JavierIH/beerbot/README.md

# beerbot
BeerBOT: beer extraction experimental research robot
