JavierIH/beerbot/doc/frontpage.tex

\newcommand{\frontpage}[4]
{
\begin{center}
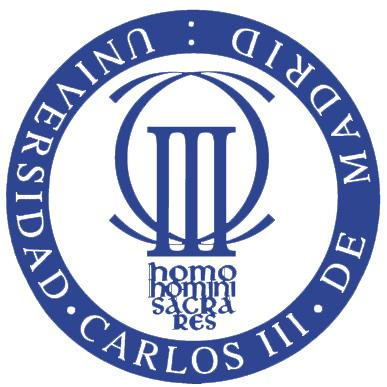
[picture p13: doc/images/uc3m.jpg]
\\[2cm]
\textsc{\LARGE Universidad Carlos III de Madrid}\\[0.5cm]
\textsc{\Large #1}\\[3cm]

% Title
{\huge \bfseries{#2}\\[7cm]}

% Author and supervisor
\begin{minipage}{0.35\textwidth}
\begin{flushleft} \large
\emph{Autores:}\\
#3\\
\end{flushleft}
\end{minipage}
\begin{minipage}{0.4\textwidth}
\begin{flushright} \large
\emph{Profesores:}\\
#4
\end{flushright}\end{minipage}\vfill

% Bottom of the page
{\large \today}

\end{center}
%
\newpage
%
}
