JavierIH/beerbot/doc/estado_del_arte.tex

\chapter{Estado del arte}
\label{estado del arte}

En esta sección se realizara un breve estudio acerca de los dos conceptos principales que conforman este trabajo. Se comenzará hablando sobre la navegación autónoma en el campo de la robótica, mostrando las diferentes partes que la conforman para a continuación entrar en el campo de la impresión 3D, centrándose en la tecnología de ámbito doméstico y su aplicación a la fabricación de robots.

\input{navegacion_de_robots}
\input{impresion_3D}
