JavierIH/beerbot/doc/software.tex

\section{Software}
\label{software}
En esta sección se pasará a explicar todo el software desarrollado para la extracción de información de la cámara, la plafinicación de la trayectoria del robot, y el software de control del robot.

\input{procesamiento}
\input{planificacion}
\input{control}
