JavierIH/beerbot/doc/images/configuration1_trajectory.png

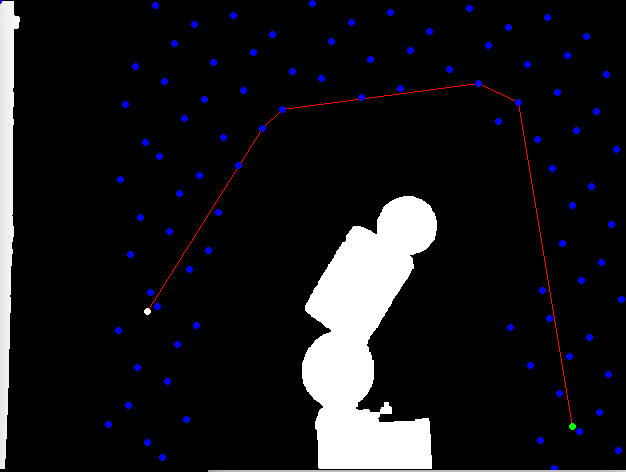
doc/images/configuration1_trajectory.png
