JavierIH/beerbot/doc/images/halton.png

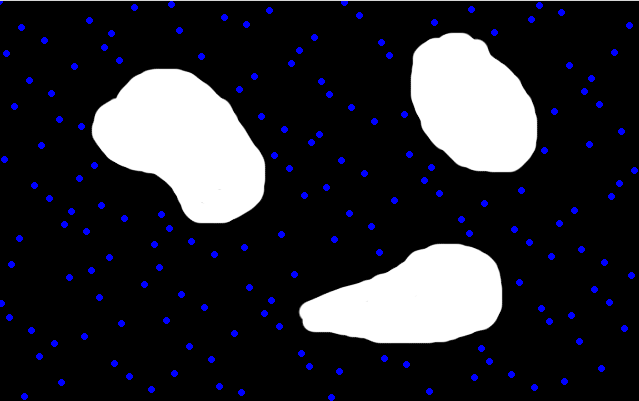
doc/images/halton.png
