JavierIH/beerbot/doc/images/random.png

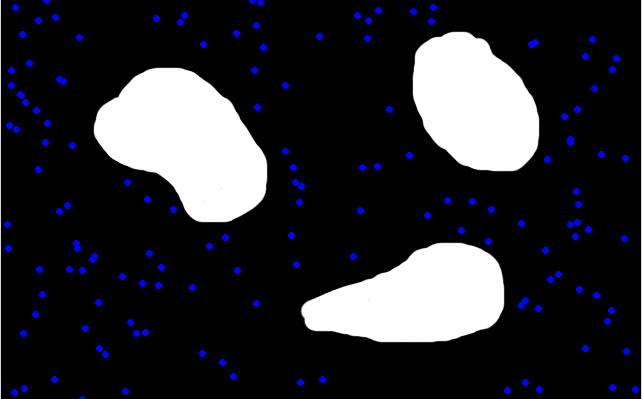
doc/images/random.png
