JavierIH/beerbot/parts/marker.pdf

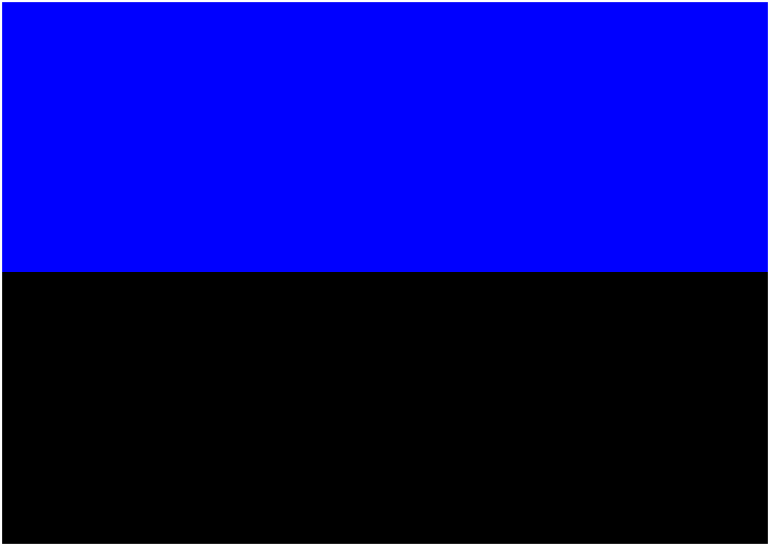
[picture p29: figure]
