JavierIH/beerbot/parts/freecad/beerbot.fcstd

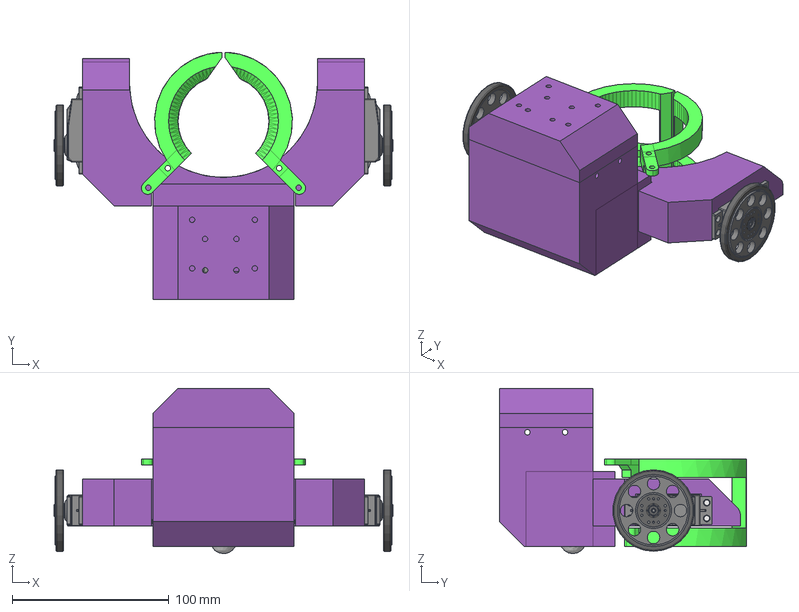
[picture p30: CAD file, 2015-06-01]
parts/freecad/beerbot.fcstd
216.4 x 158.0 x 105.5 mm
servo009
servo009 (Mirror #1)
Fusion007 (Mirror #5)
servo010
final-model
final-model001
final-model001 (Mirror #8)
Cut045 (Mirror #9)
Fillet003 (Mirror #10)
Chamfer011 (Mirror #10)
