JavierIH/beerbot/parts/stl/roof.stl

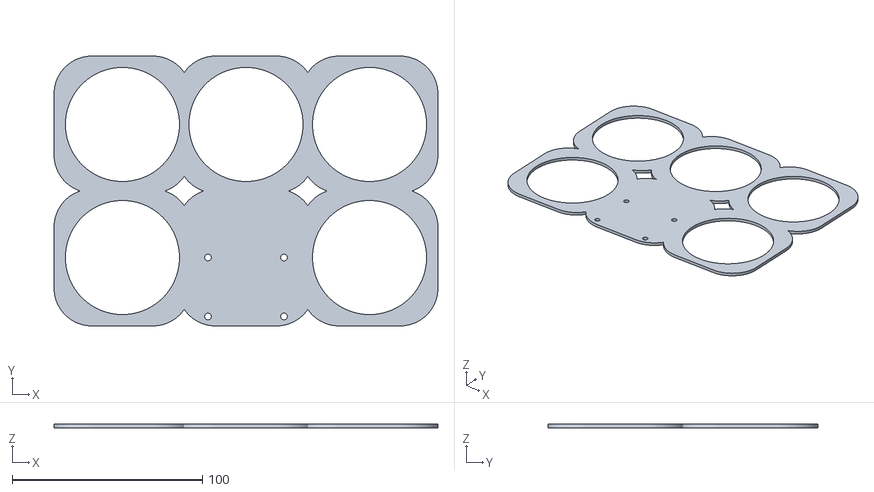
[picture p31: CAD file, 2015-06-01]
parts/stl/roof.stl
202.0 x 142.0 x 2.00
