JavierIH/beerbot/parts/stl/llanta.stl

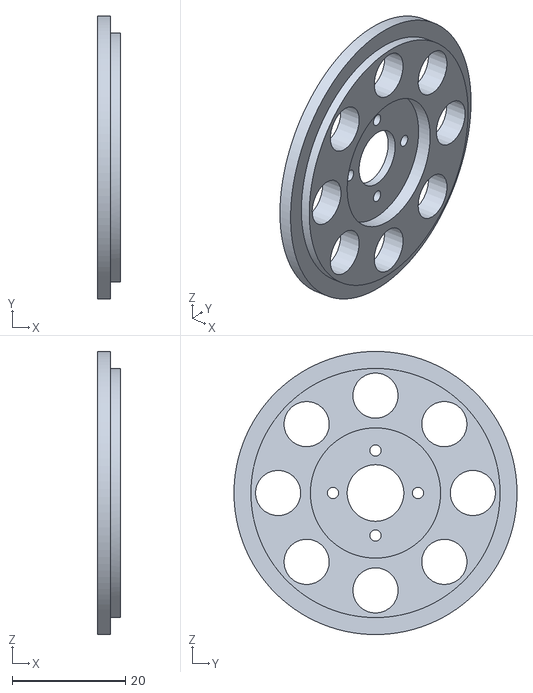
[picture p32: CAD file, 2015-05-27]
parts/stl/llanta.stl
4.00 x 50.0 x 50.0
