JavierIH/beerbot/parts/stl/tapa.stl

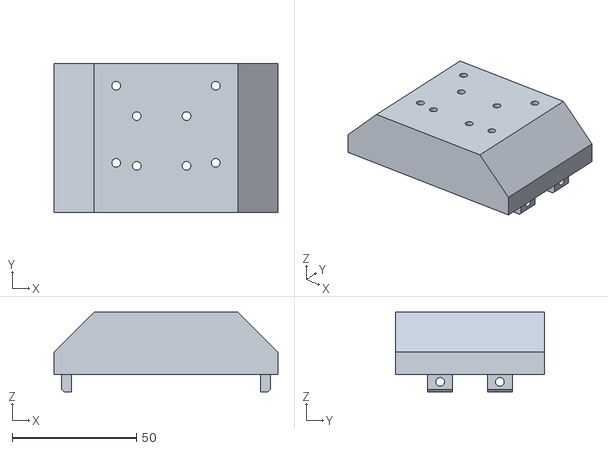
[picture p33: CAD file, 2015-05-27]
parts/stl/tapa.stl
90.0 x 60.0 x 32.0
