JavierIH/beerbot/parts/stl/chasis.stl

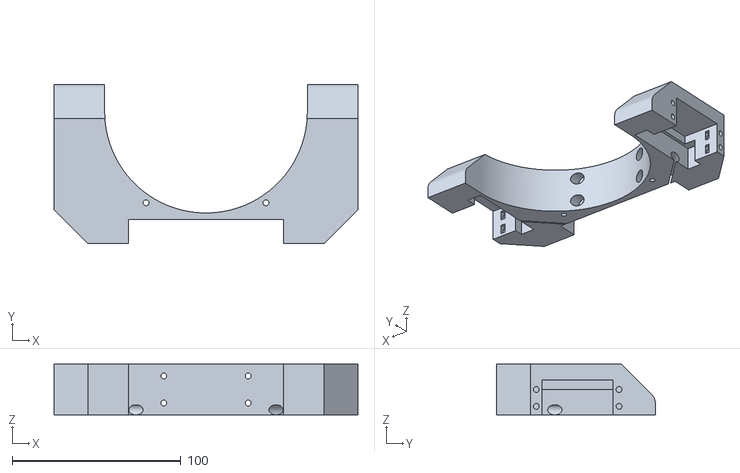
[picture p34: CAD file, 2015-05-27]
parts/stl/chasis.stl
180.0 x 94.0 x 30.0
