JavierIH/beerbot/parts/stl/biela.stl

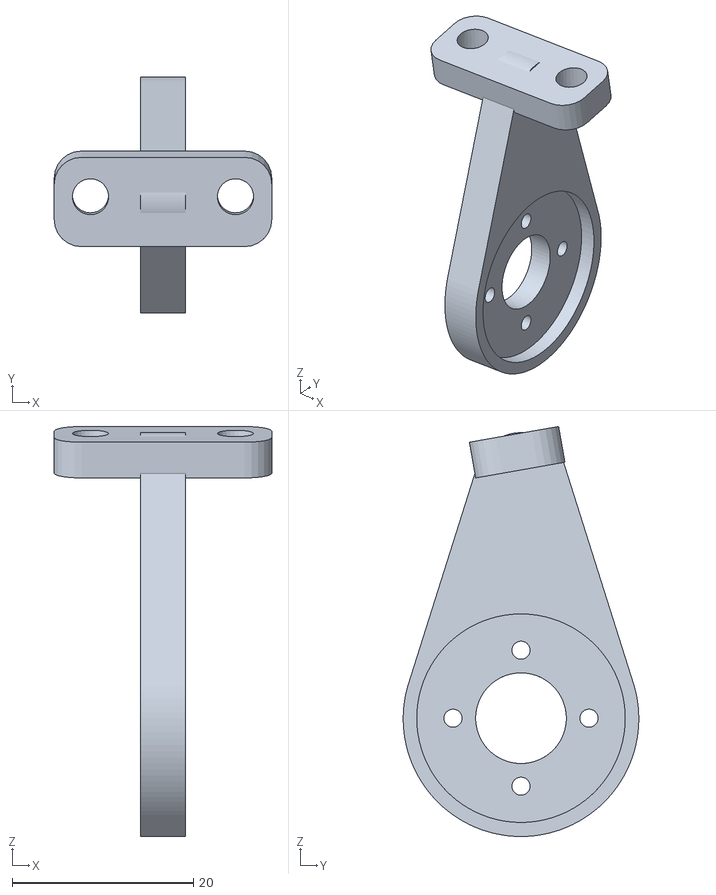
[picture p35: CAD file, 2015-05-21]
parts/stl/biela.stl
24.0 x 26.0 x 45.2
