JavierIH/beerbot/parts/stl/caja.stl

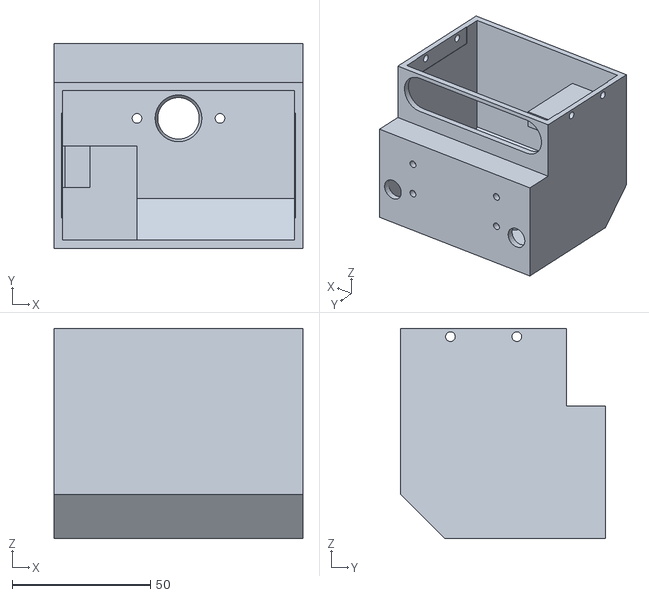
[picture p36: CAD file, 2015-05-21]
parts/stl/caja.stl
90.0 x 74.0 x 76.0
