JavierIH/beerbot/parts/stl/portabola.stl

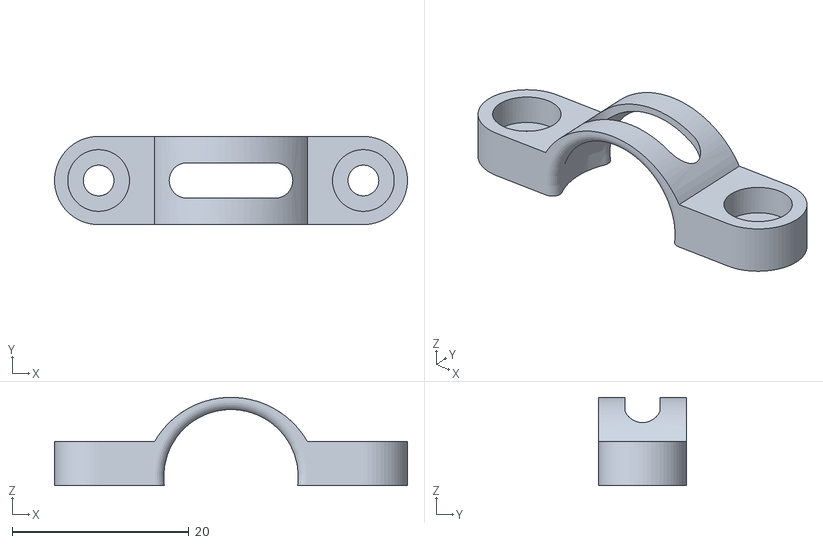
[picture p37: CAD file, 2015-05-21]
parts/stl/portabola.stl
40.0 x 10.0 x 10.0
