JavierIH/beerbot/parts/stl/pinzaD.stl

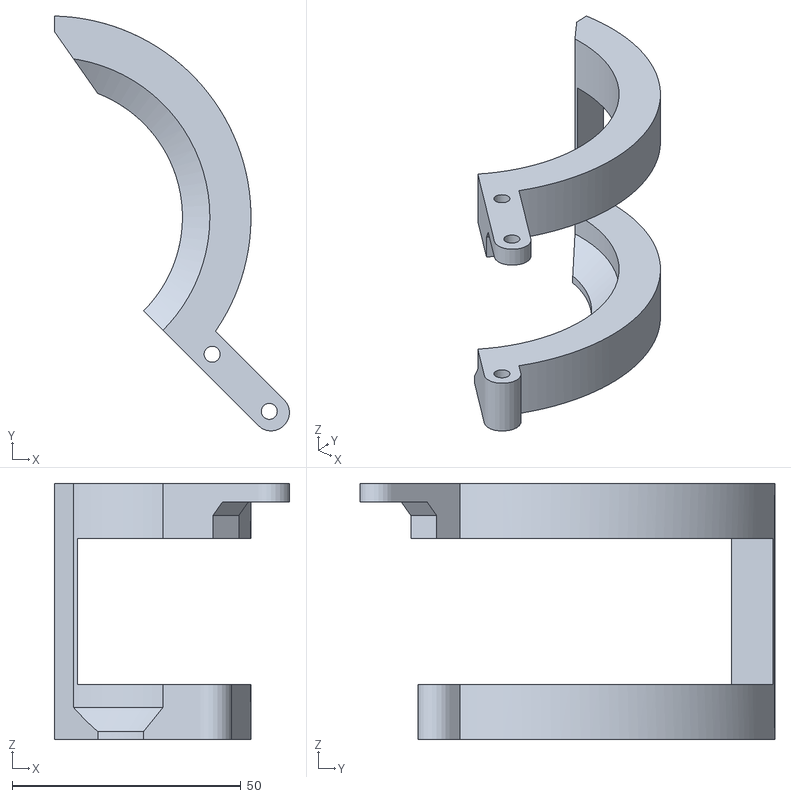
[picture p38: CAD file, 2015-05-17]
parts/stl/pinzaD.stl
51.4 x 90.8 x 56.0
