JavierIH/beerbot/(list of files, cad)

Other CAD files:
parts/stl/pinzaI.stl
