JavierIH/beerbot/software/sandbox/Vision/prueba1.jpg

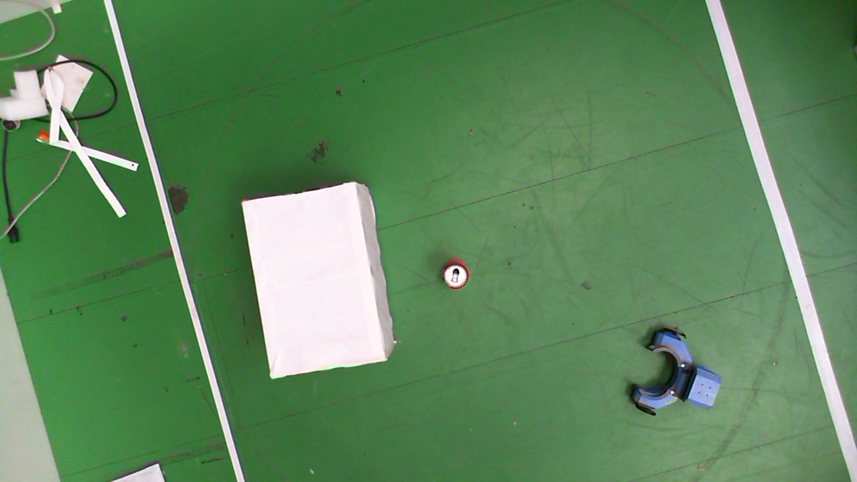
software/sandbox/Vision/prueba1.jpg
