JavierIH/beerbot/software/sandbox/Vision/prueba2.jpg

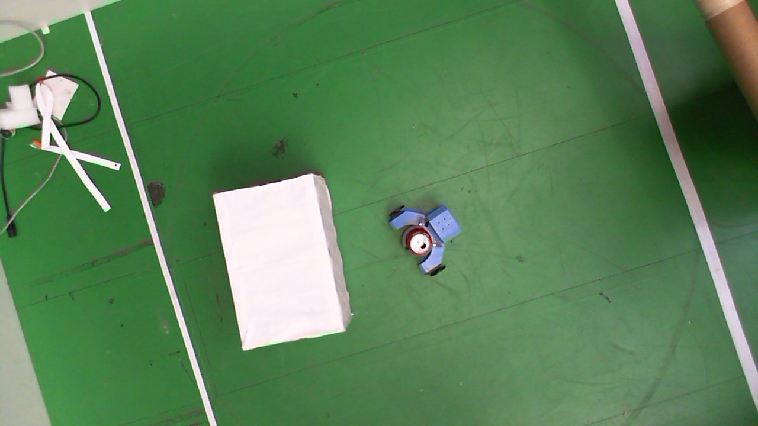
software/sandbox/Vision/prueba2.jpg
