JavierIH/beerbot/software/sandbox/Vision/prueba3.jpg

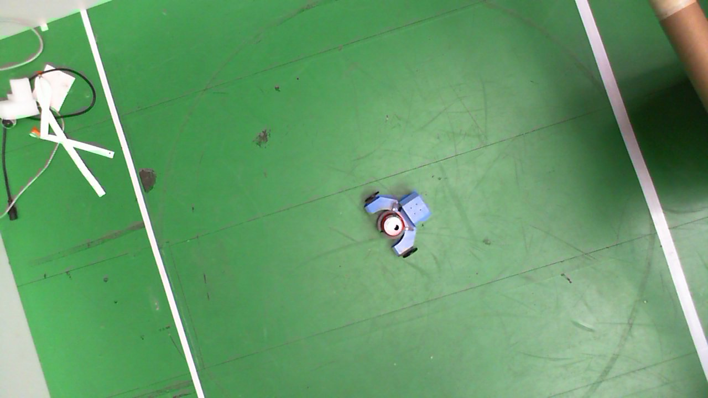
software/sandbox/Vision/prueba3.jpg
