JavierIH/beerbot/software/sandbox/Vision/prueba4.jpg

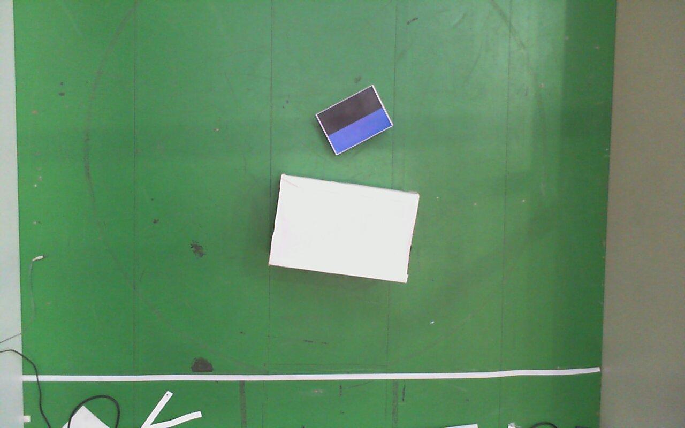
software/sandbox/Vision/prueba4.jpg
