JavierIH/beerbot/software/sandbox/Vision/prueba5.jpg

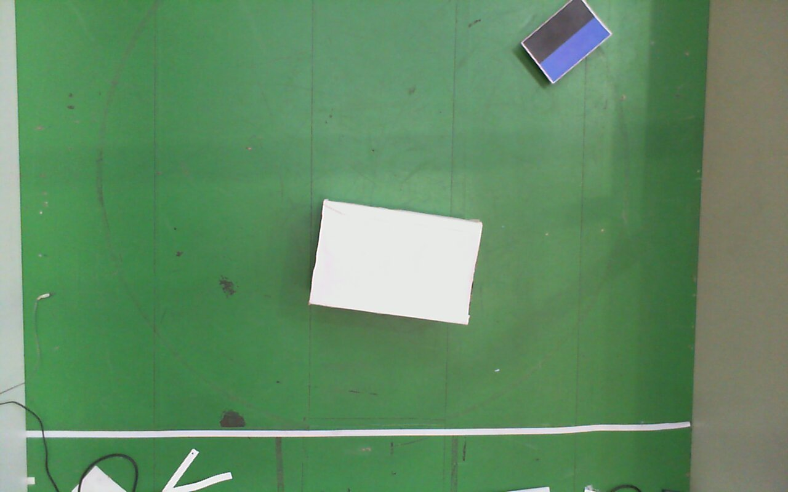
software/sandbox/Vision/prueba5.jpg
