JavierIH/beerbot/software/src/CameraCalibration/calibration_image0.png

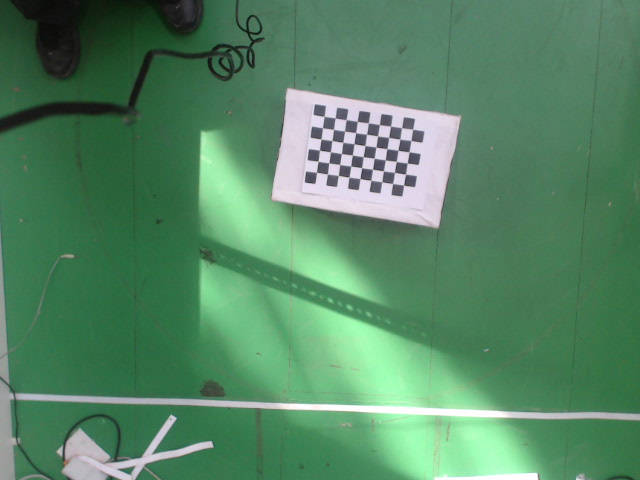
software/src/CameraCalibration/calibration_image0.png
