JavierIH/beerbot/software/src/CameraCalibration/calibration_image1.png

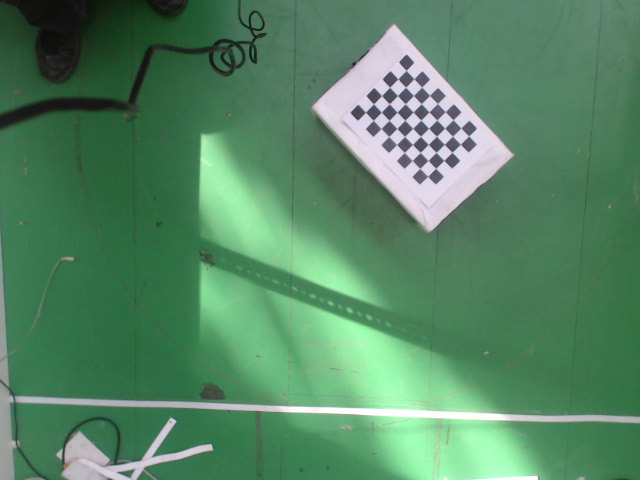
software/src/CameraCalibration/calibration_image1.png
