JavierIH/beerbot/software/src/CameraCalibration/calibration_image2.png

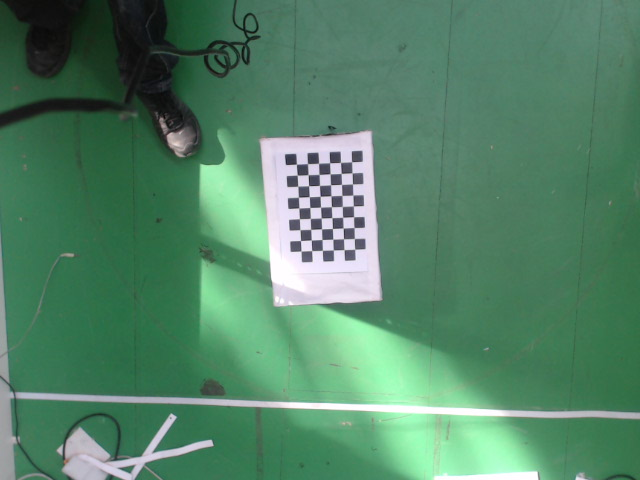
software/src/CameraCalibration/calibration_image2.png
