JavierIH/beerbot/software/src/CameraCalibration/calibration_image3.png

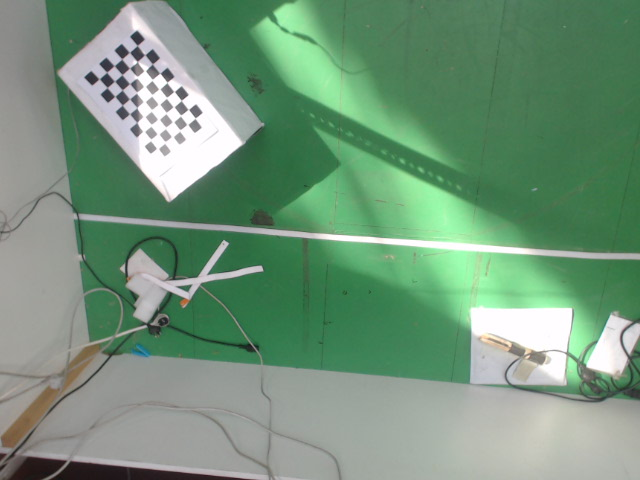
software/src/CameraCalibration/calibration_image3.png
