JavierIH/beerbot/software/src/CameraCalibration/calibration_image4.png

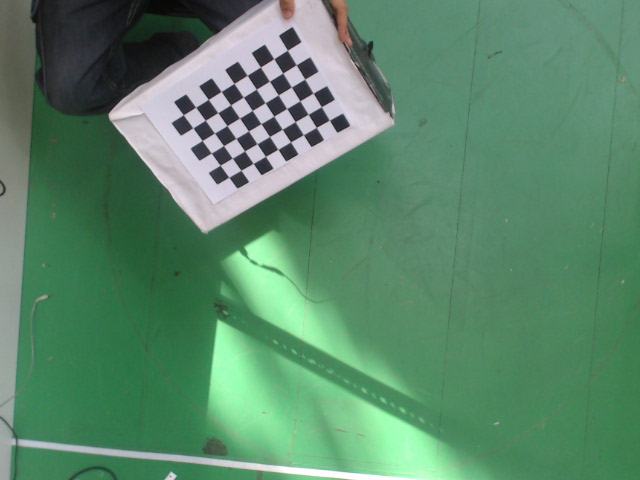
software/src/CameraCalibration/calibration_image4.png
