JavierIH/beerbot/software/src/CameraCalibration/calibration_image5.png

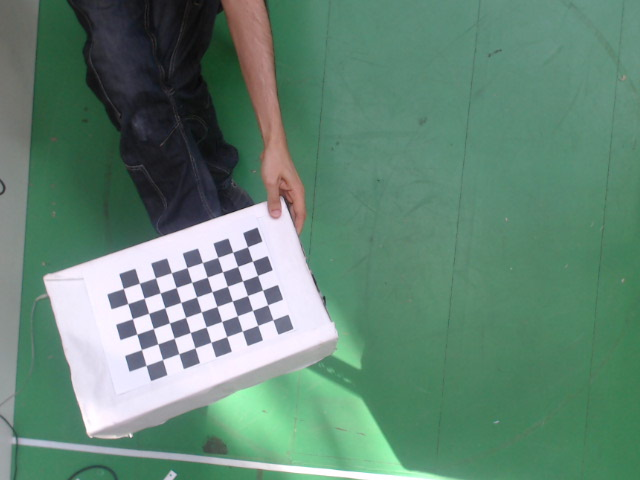
software/src/CameraCalibration/calibration_image5.png
