JavierIH/beerbot/software/src/CameraCalibration/calibration_image6.png

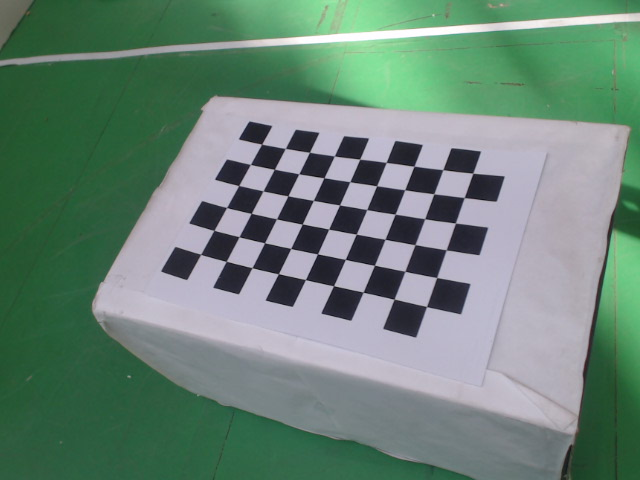
software/src/CameraCalibration/calibration_image6.png
