JavierIH/beerbot/software/src/CameraCalibration/calibration_image7.png

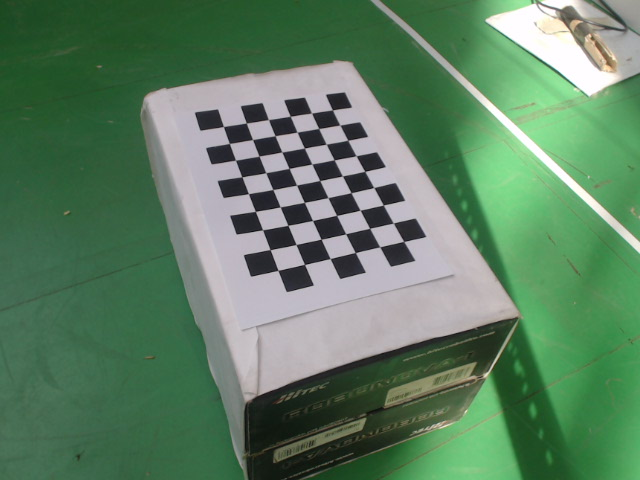
software/src/CameraCalibration/calibration_image7.png
