JavierIH/beerbot/software/src/CameraCalibration/calibration_image8.png

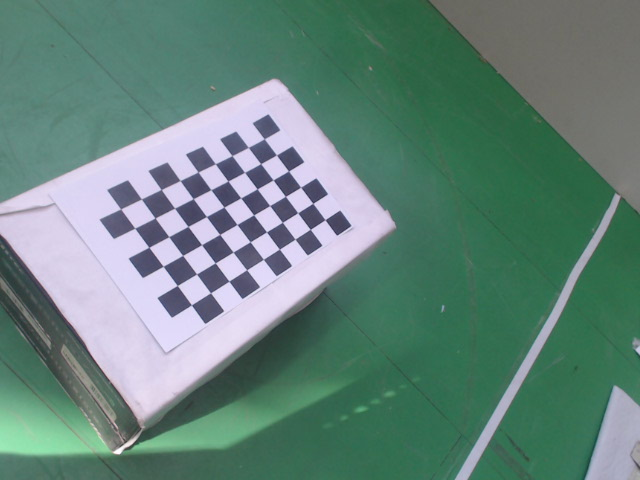
software/src/CameraCalibration/calibration_image8.png
