JavierIH/beerbot/software/src/CameraCalibration/calibration_image9.png

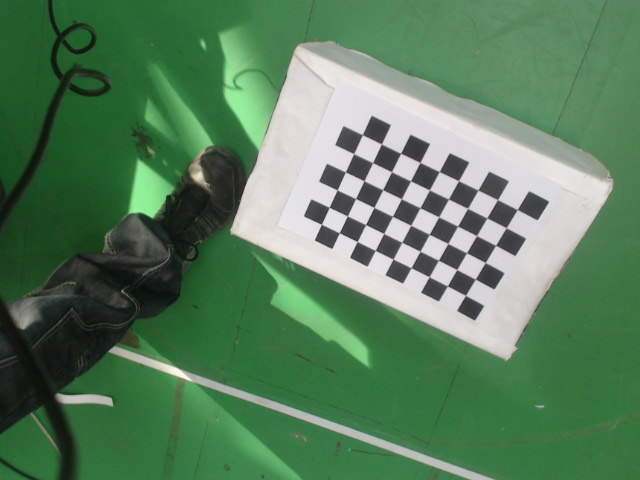
software/src/CameraCalibration/calibration_image9.png
