JavierIH/beerbot/software/src/CameraCalibration/calibration_image10.png

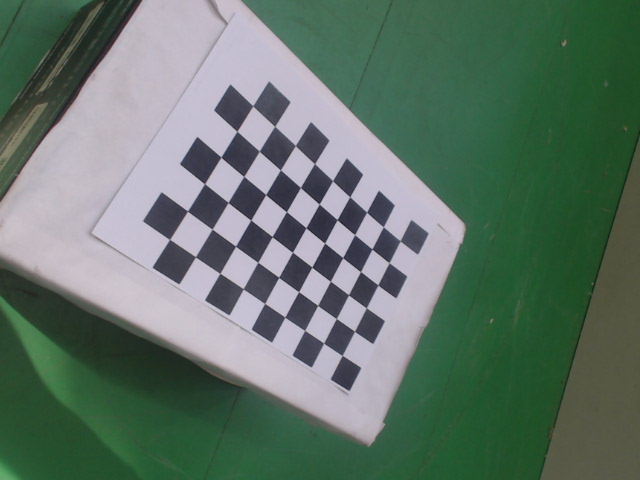
software/src/CameraCalibration/calibration_image10.png
