JavierIH/beerbot/software/src/CameraCalibration/calibration_image11.png

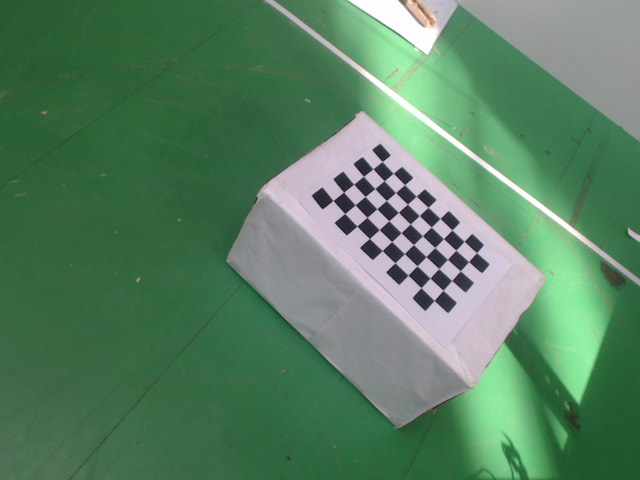
software/src/CameraCalibration/calibration_image11.png
