JavierIH/beerbot/software/src/CameraCalibration/calibration_image12.png

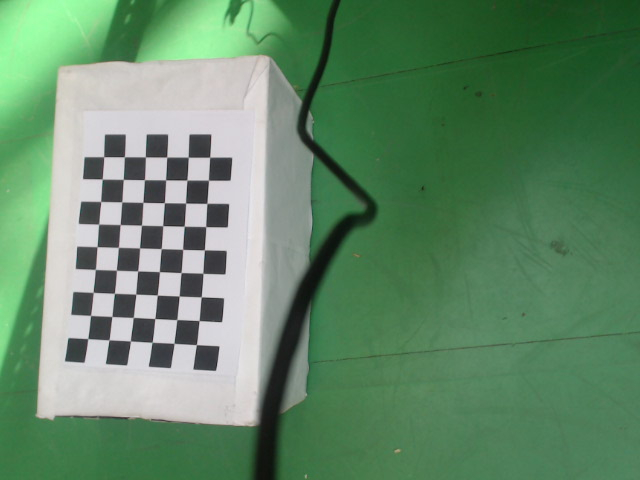
software/src/CameraCalibration/calibration_image12.png
