JavierIH/beerbot/software/src/CameraCalibration/calibration_image13.png

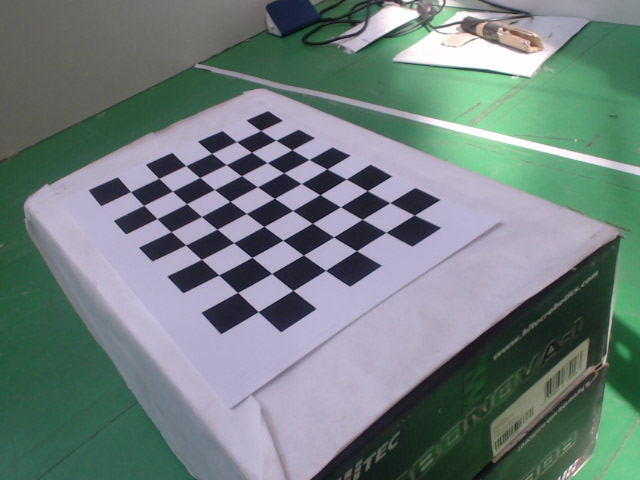
software/src/CameraCalibration/calibration_image13.png
