JavierIH/beerbot/software/src/CameraCalibration/calibration_image_0.png

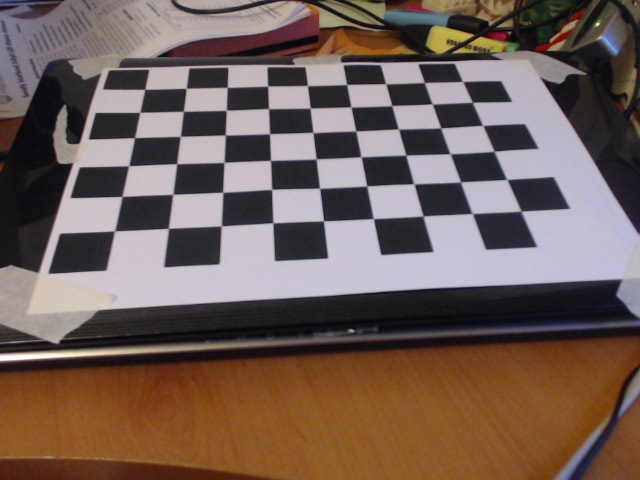
software/src/CameraCalibration/calibration_image_0.png
