JavierIH/beerbot/software/src/CameraCalibration/calibration_image_1.png

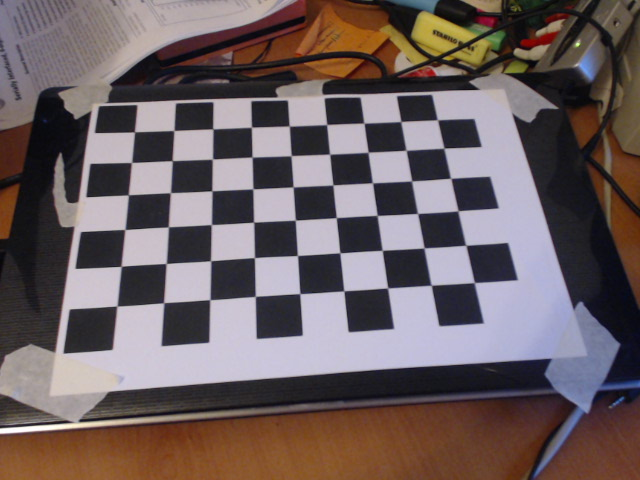
software/src/CameraCalibration/calibration_image_1.png
