JavierIH/beerbot/software/src/CameraCalibration/calibration_image_2.png

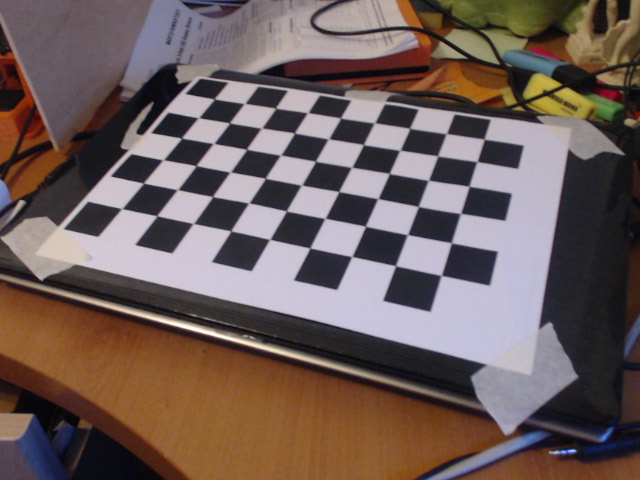
software/src/CameraCalibration/calibration_image_2.png
