JavierIH/beerbot/software/src/CameraCalibration/calibration_image_3.png

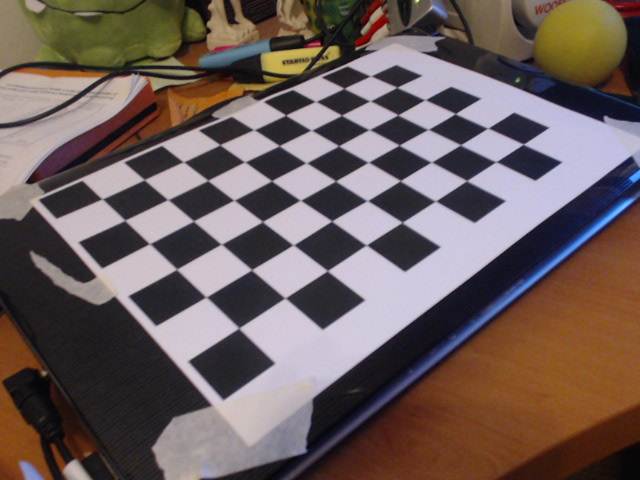
software/src/CameraCalibration/calibration_image_3.png
