JavierIH/beerbot/software/src/CameraCalibration/calibration_image_4.png

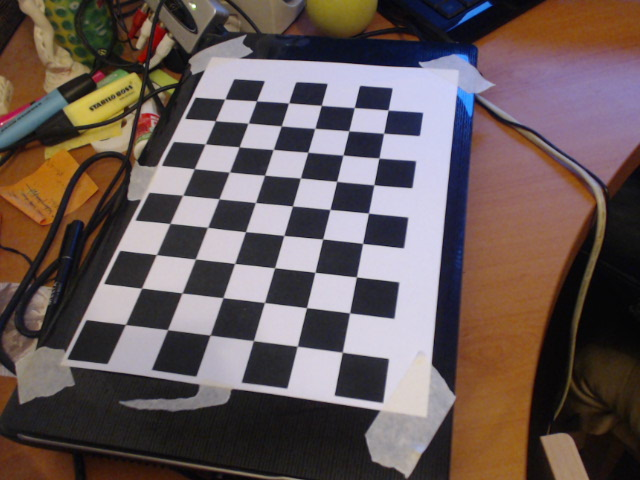
software/src/CameraCalibration/calibration_image_4.png
