JavierIH/beerbot/software/src/CameraCalibration/calibration_image_5.png

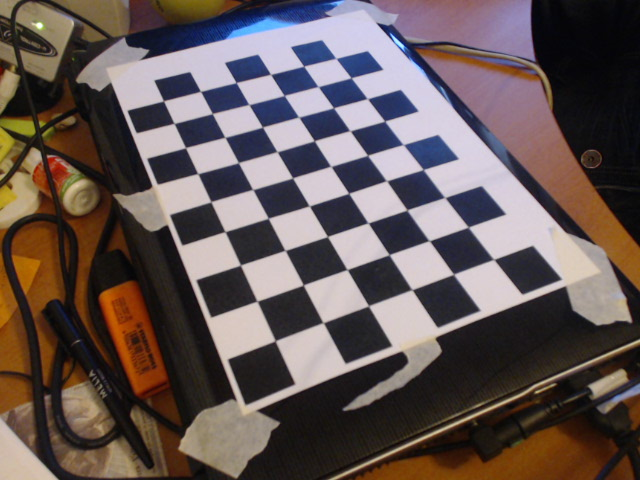
software/src/CameraCalibration/calibration_image_5.png
