JavierIH/beerbot/software/src/CameraCalibration/calibration_image_6.png

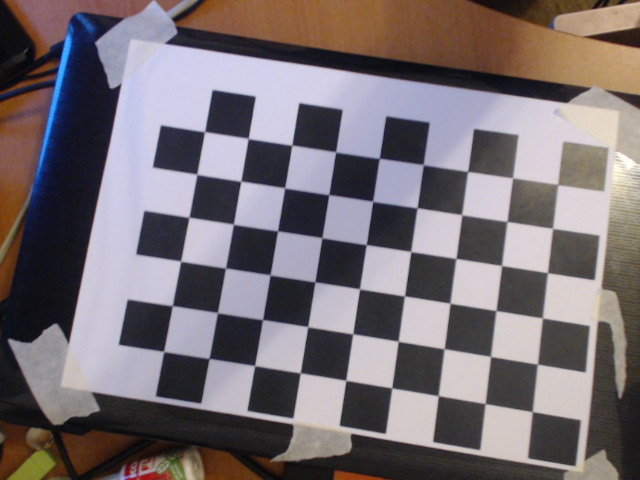
software/src/CameraCalibration/calibration_image_6.png
