JavierIH/beerbot/software/src/CameraCalibration/calibration_image_7.png

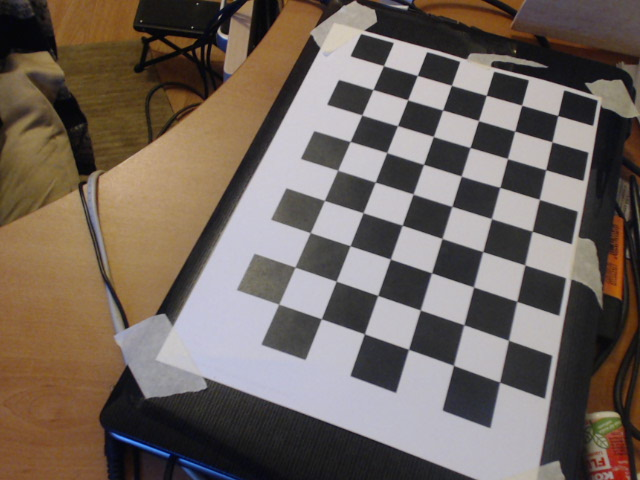
software/src/CameraCalibration/calibration_image_7.png
