JavierIH/beerbot/software/src/CameraCalibration/calibration_image_8.png

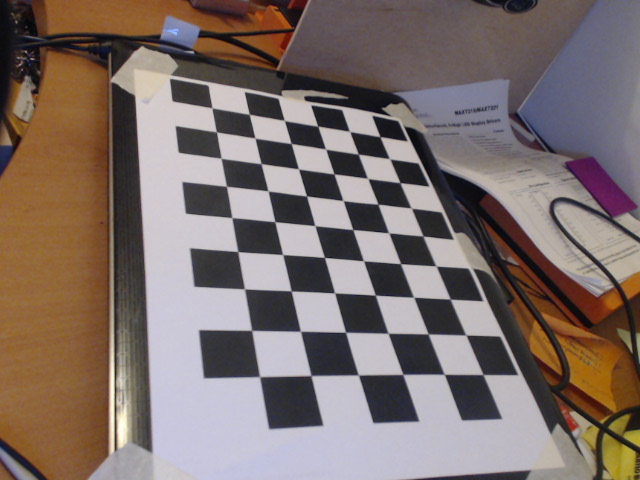
software/src/CameraCalibration/calibration_image_8.png
