JavierIH/beerbot/software/src/CameraCalibration/calibration_image_9.png

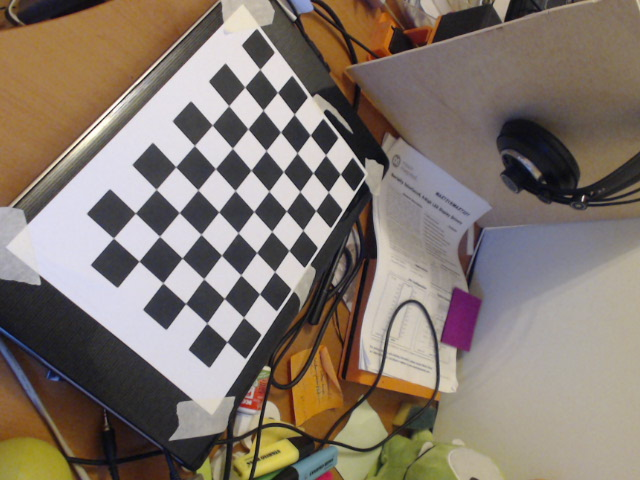
software/src/CameraCalibration/calibration_image_9.png
