JavierIH/beerbot/software/src/CameraCalibration/calibration_image_10.png

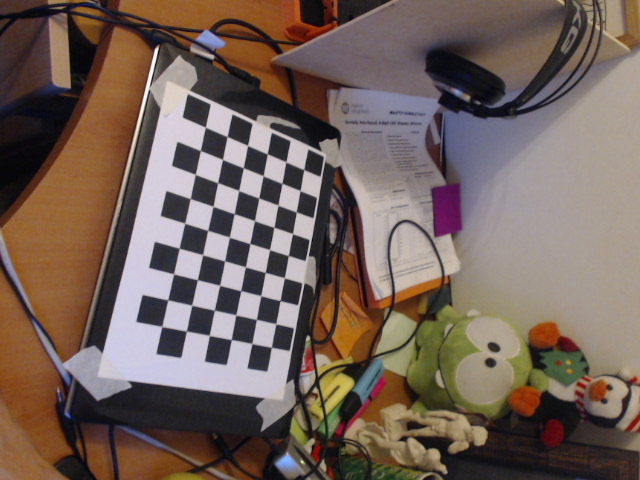
software/src/CameraCalibration/calibration_image_10.png
