JavierIH/beerbot/software/src/CameraCalibration/calibration_image_11.png

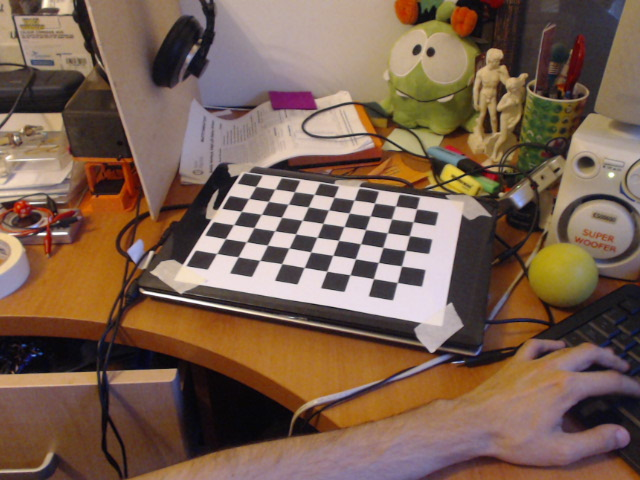
software/src/CameraCalibration/calibration_image_11.png
