JavierIH/beerbot/software/src/CameraCalibration/calibration_image_12.png

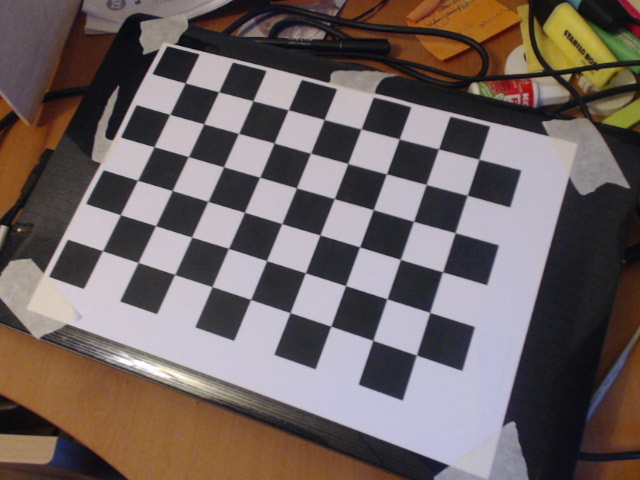
software/src/CameraCalibration/calibration_image_12.png
