JavierIH/beerbot/software/src/CameraCalibration/calibration_image_13.png

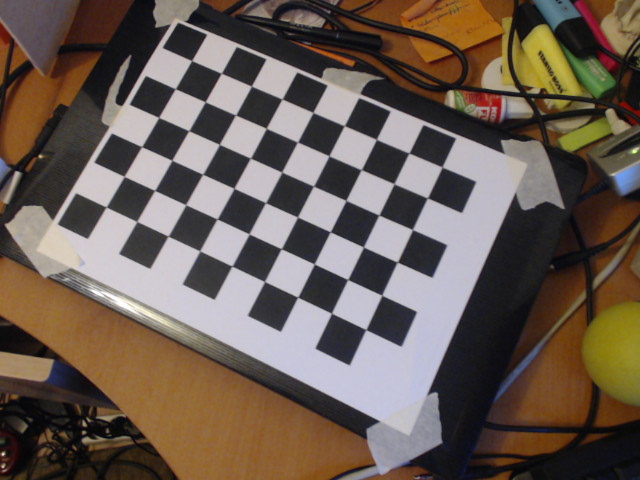
software/src/CameraCalibration/calibration_image_13.png
