JavierIH/beerbot/software/src/CameraCalibration/logitech/calibration_image0.png

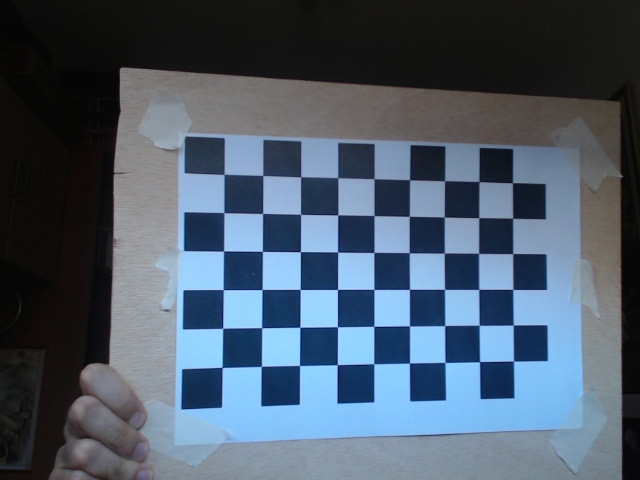
software/src/CameraCalibration/logitech/calibration_image0.png
