JavierIH/beerbot/software/src/CameraCalibration/logitech/calibration_image1.png

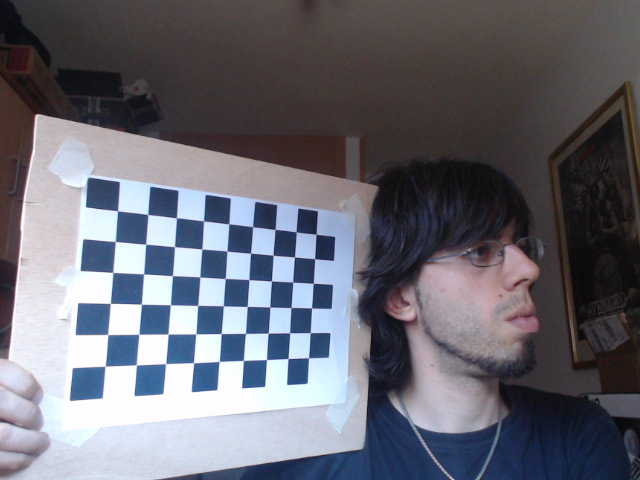
software/src/CameraCalibration/logitech/calibration_image1.png
