JavierIH/beerbot/software/src/CameraCalibration/logitech/calibration_image3.png

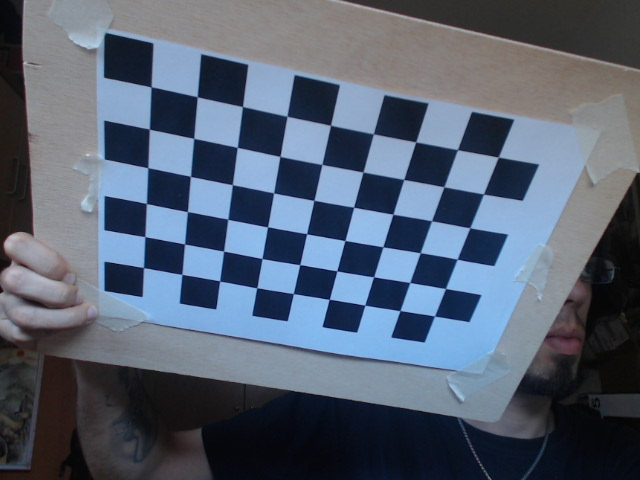
software/src/CameraCalibration/logitech/calibration_image3.png
