JavierIH/beerbot/software/src/CameraCalibration/logitech/calibration_image4.png

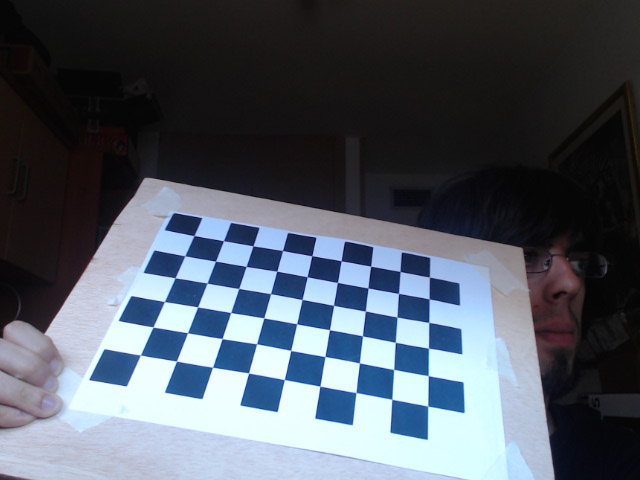
software/src/CameraCalibration/logitech/calibration_image4.png
