JavierIH/beerbot/software/src/CameraCalibration/logitech/calibration_image5.png

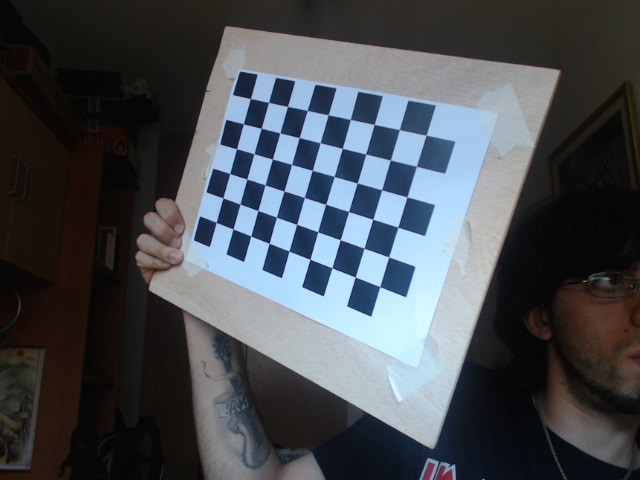
software/src/CameraCalibration/logitech/calibration_image5.png
