JavierIH/beerbot/software/src/CameraCalibration/logitech/calibration_image6.png

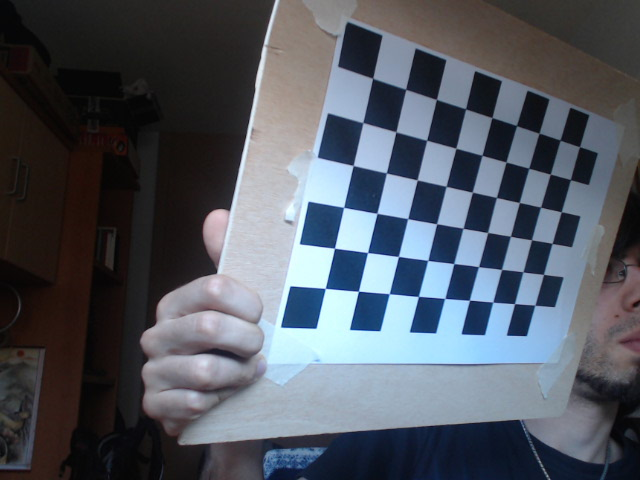
software/src/CameraCalibration/logitech/calibration_image6.png
