JavierIH/beerbot/software/src/CameraCalibration/logitech/calibration_image7.png

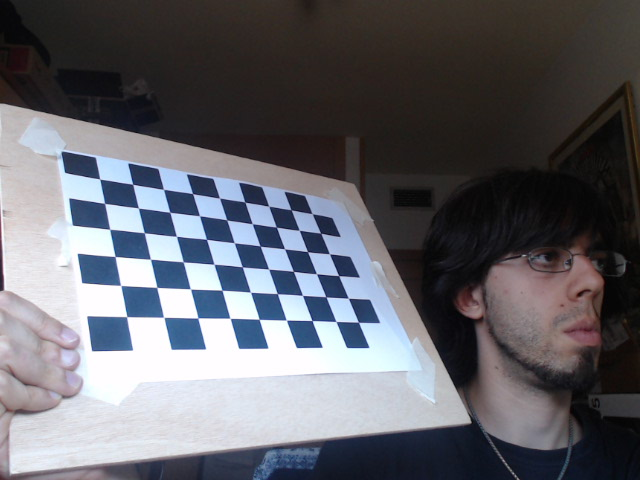
software/src/CameraCalibration/logitech/calibration_image7.png
