JavierIH/beerbot/software/src/CameraCalibration/logitech/calibration_image8.png

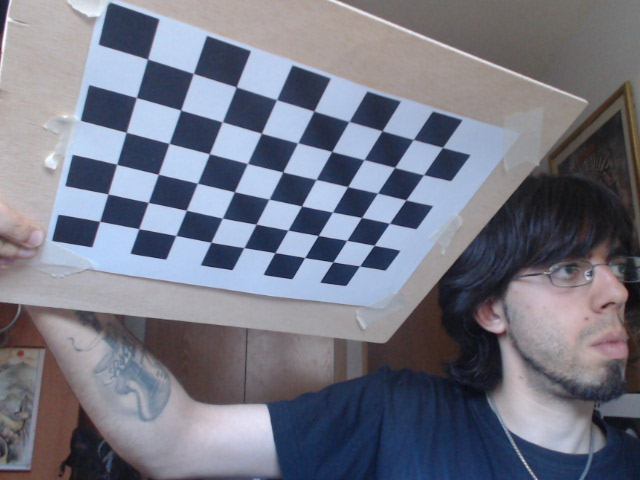
software/src/CameraCalibration/logitech/calibration_image8.png
