JavierIH/beerbot/software/src/CameraCalibration/logitech/calibration_image9.png

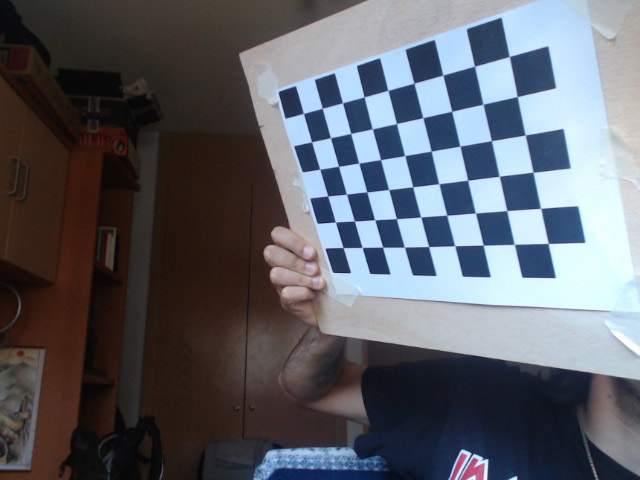
software/src/CameraCalibration/logitech/calibration_image9.png
