JavierIH/beerbot/software/src/CameraCalibration/logitech/calibration_image10.png

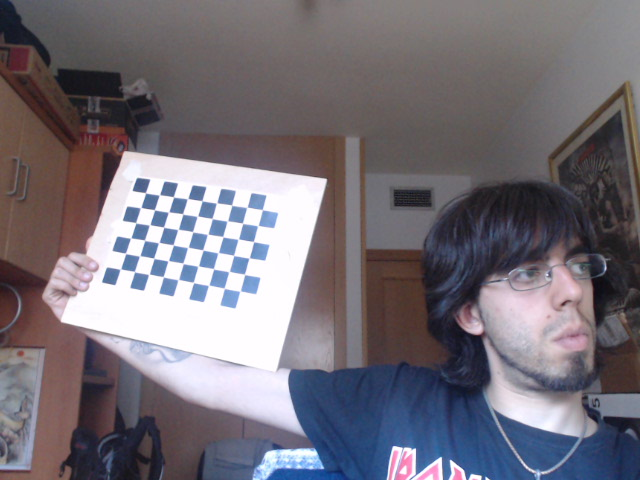
software/src/CameraCalibration/logitech/calibration_image10.png
