JavierIH/beerbot/software/src/CameraCalibration/logitech/calibration_image11.png

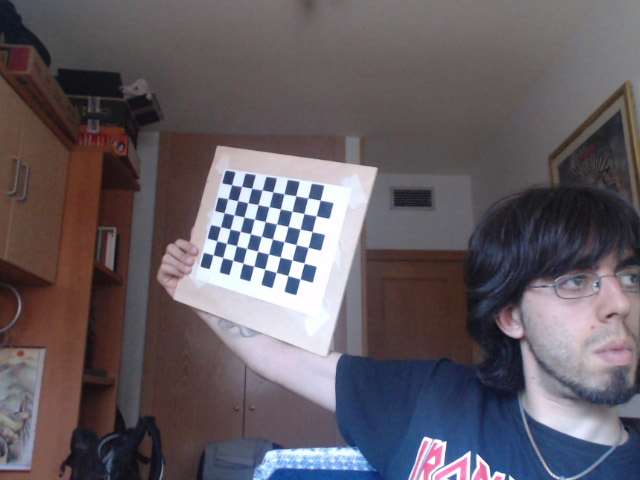
software/src/CameraCalibration/logitech/calibration_image11.png
