JavierIH/beerbot/software/src/CameraCalibration/logitech/calibration_image12.png

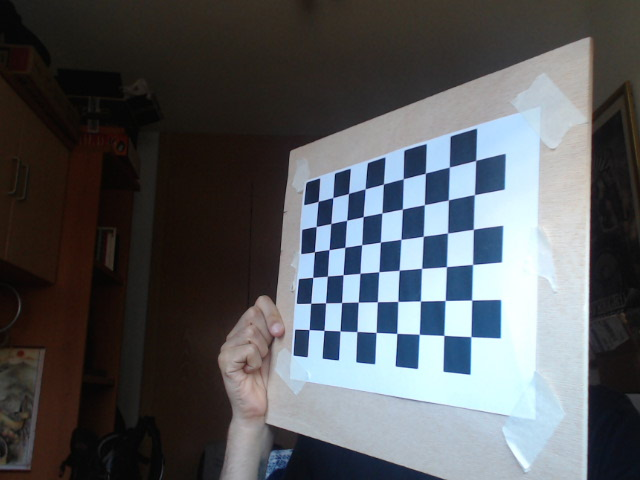
software/src/CameraCalibration/logitech/calibration_image12.png
