JavierIH/beerbot/software/src/CameraCalibration/logitech/calibration_image13.png

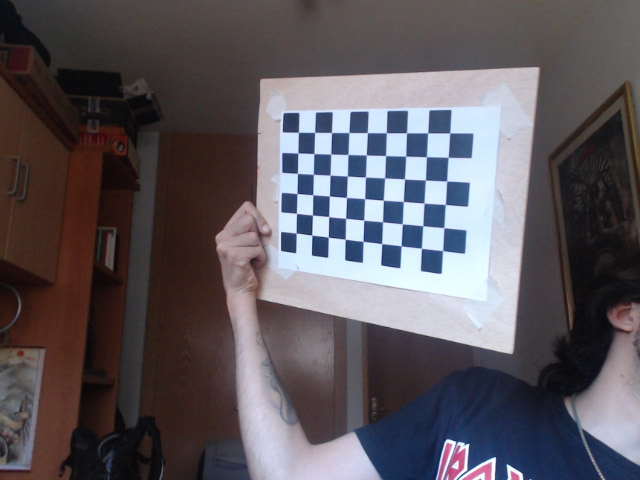
software/src/CameraCalibration/logitech/calibration_image13.png
