JavierIH/beerbot/software/src/CameraCalibration/logitech/calibration_imageextra.png

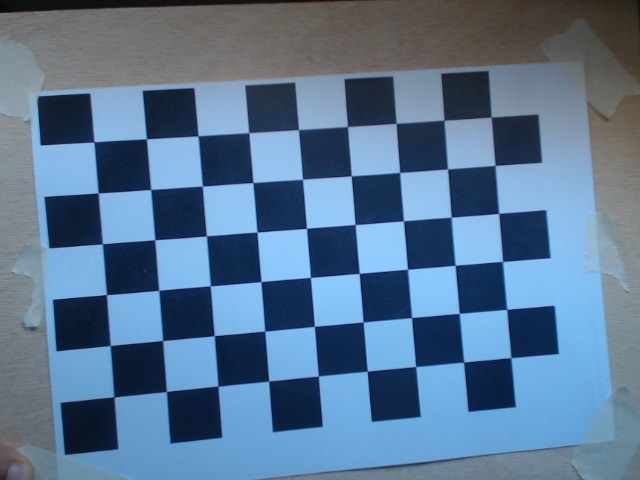
software/src/CameraCalibration/logitech/calibration_imageextra.png
