JavierIH/beerbot/doc/plano.pdf

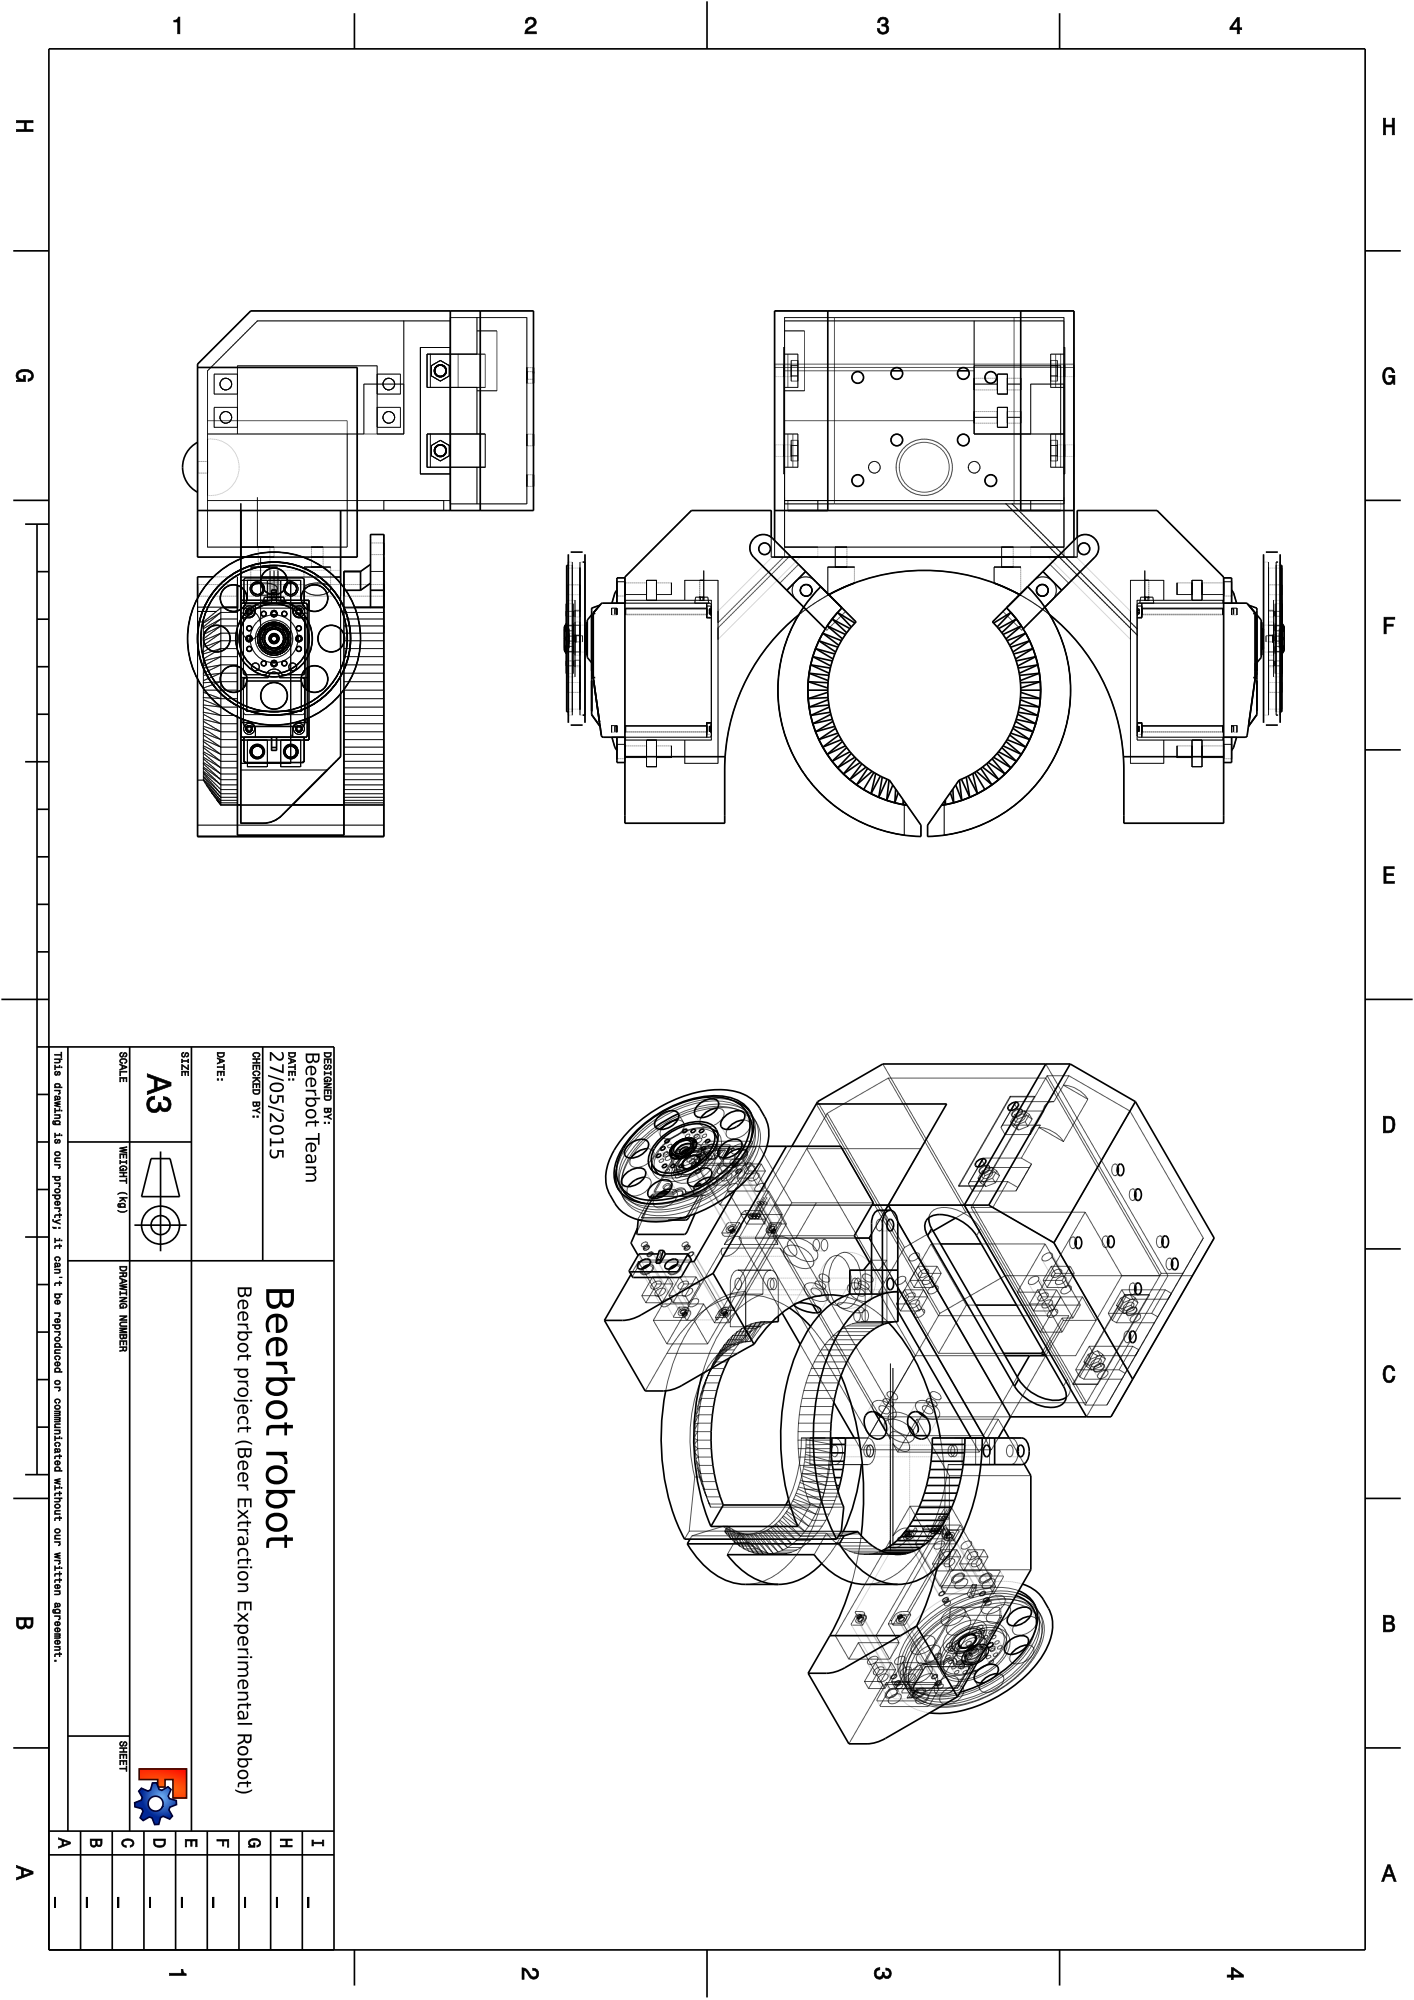
[picture p89: page 1]
