JavierIH/beerbot/(commit log)

2015-05-17 Added 3d model of the first BeerBOT prototype
    [beerbot.fcstd, caja.stl, chasis.stl, llanta.stl, pinzaD.stl, pinzaI.stl, tapa.stl]
2015-05-20 Add calibration scripts
2015-05-21 Added firmware
    [beerbot.fcstd, biela.stl, caja.stl, portabola.stl]
2015-05-21 Updated calibration script
2015-05-23 Camera class for detecting robot and goal pose and environment
2015-05-24 Fixed bugs on calibration script
2015-05-24 Add calibration files for logitech webcam
2015-05-24 Solved issues with calibrated camera
2015-05-25 New six-pack roof for placing a marker on the BeerBot
    [beerbot.fcstd]
2015-05-27 updated chasis
    [beerbot.fcstd, chasis.stl, llanta.stl, tapa.stl]
2015-05-28 Integration, not working yet
    [Beerbot.py, Camera.py, Control.py, Main.py]
2015-05-29 More on calibration (report)
2015-05-29 More on image processing and calibration
2015-05-31 Add marker file ready to be printed
2015-05-31 minor changes
    [beerbot.fcstd]
2015-05-31 Pictures and roof part
    [roof.stl]
